HOOGOGOGO/-/(list of files, cad)

Other CAD files:
电子指南针/Objects/main.obj
电子指南针/Objects/led.obj
电子指南针/Objects/sys.obj
电子指南针/Objects/iic.obj
