HOOGOGOGO/-/电子指南针/sys/led.c

//本程序只供学习使用，未经作者许可，不得用于其它任何用途
//测试硬件：单片机STC89C52,晶振11.0592M  单片机工作电压3.8V
//QDtech-TFT液晶驱动 for C51
//协会网站:https://hoogogogo.github.io/YanZhiBo/
//协会提供技术支持，任何技术问题欢迎随时交流学习
//邮箱:1711446177@qq.com
//技术交流QQ群:111446177
//创建日期:2024/9/7
//版本：V1.0
//版权所有，盗版必究。
//Copyright(C) 燕之波协会 2024-2034
#include "sys.h"
#include "led.h"

//LCD的画笔颜色和背景色	   
extern u16  POINT_COLOR=WHITE;	//画笔颜色
extern u16  BACK_COLOR=BLACK;  //背景色 

u8 size=24;


//LCD重要参数集
typedef struct  
{										    
	u8 width;			//LCD 宽度
	u8 height;			//LCD 高度
	u16 id;				//LCD ID
	u8  dir;			//横屏还是竖屏控制：0，竖屏；1，横屏。	
	u16	 wramcmd;		//开始写gram指令
	u16  setxcmd;		//设置x坐标指令
	u16  setycmd;		//设置y坐标指令
	u8   xoffset;    
  u8	 yoffset;	
}_lcd_dev; 	


//管理LCD重要参数
//默认为竖屏
_lcd_dev lcddev;

//24*24 ASICII字符集点阵
unsigned char code ascii_2412[27][36]={  
{0x00,0x00,0x00,0x00,0x00,0x00,0x00,0x00,0x00,0x00,0x00,0x00,0x00,0x00,0x00,0x00,0x00,0x00,0x00,0x00,0x00,0x00,0x00,0x00,0x00,0x00,0x00,0x00,0x00,0x00,0x00,0x00,0x00,0x00,0x00,0x00},/*" ",0*/
{0x00,0x00,0x00,0x00,0x00,0x00,0x00,0x00,0x00,0x00,0x00,0x00,0x00,0x00,0x00,0x0F,0x80,0x38,0x0F,0xFE,0x38,0x0F,0x80,0x38,0x00,0x00,0x00,0x00,0x00,0x00,0x00,0x00,0x00,0x00,0x00,0x00},/*"!",1*/
{0x00,0x00,0x00,0x00,0x00,0x00,0x01,0x00,0x00,0x06,0x00,0x00,0x0C,0x00,0x00,0x38,0x00,0x00,0x31,0x00,0x00,0x06,0x00,0x00,0x0C,0x00,0x00,0x38,0x00,0x00,0x30,0x00,0x00,0x00,0x00,0x00},/*""",2*/
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
 * @retvalue   :None
******************************************************************************/
void spi_write_byte(u8 d)
{
	u8 val=0x80;
	while(val)
	{
		if(d&val)
		{
			LCD_SDI = 1;
		}
		else
		{
			LCD_SDI = 0;
		}
		LCD_CLK = 0;
		LCD_CLK = 1;
		val>>=1;
	}
}

/*****************************************************************************
 * @name       :void LCD_WR_REG(u8 data)
 * @date       :2018-08-09 
 * @function   :Write an 8-bit command to the LCD screen
 * @parameters :data:Command value to be written
 * @retvalue   :None
******************************************************************************/
void LCD_WR_REG(u8 Reg)	 
{	
	LCD_RS=0;
	LCD_CS=0;
	spi_write_byte(Reg);
	LCD_CS=1;
} 

/*****************************************************************************
 * @name       :void LCD_WR_DATA(u8 data)
 * @date       :2018-08-09 
 * @function   :Write an 8-bit data to the LCD screen
 * @parameters :data:data value to be written
 * @retvalue   :None
******************************************************************************/
 void LCD_WR_DATA(u8 Data)
{
	LCD_RS=1;
	LCD_CS=0;
	spi_write_byte(Data);
	LCD_CS=1;
}

/*****************************************************************************
 * @name       :void LCD_WR_DATA_16Bit(u16 Data)
 * @date       :2018-08-09 
 * @function   :Write an 16-bit command to the LCD screen
 * @parameters :Data:Data to be written
 * @retvalue   :None
******************************************************************************/	 
void LCD_WR_DATA_16Bit(u16 Data)
{
	LCD_CS=0;
	LCD_RS=1;
	spi_write_byte(Data>>8);
	spi_write_byte(Data);
	LCD_CS=1;
}

/*****************************************************************************
 * @name       :void LCD_WriteReg(u8 LCD_Reg, u16 LCD_RegValue)
 * @date       :2018-08-09 
 * @function   :Write data into registers
 * @parameters :LCD_Reg:Register address
                LCD_RegValue:Data to be written
 * @retvalue   :None
******************************************************************************/
void LCD_WriteReg(u8 LCD_Reg, u8 LCD_RegValue)
{
  LCD_WR_REG(LCD_Reg);
	LCD_WR_DATA(LCD_RegValue);
}

/*****************************************************************************
 * @name       :void LCD_WriteRAM_Prepare(void)
 * @date       :2018-08-09 
 * @function   :Write GRAM
 * @parameters :None
 * @retvalue   :None
******************************************************************************/	
void LCD_WriteRAM_Prepare(void)
{
 	LCD_WR_REG(lcddev.wramcmd);	  
}

/*****************************************************************************
 * @name       :void LCD_Clear(u16 Color)
 * @date       :2018-08-09 
 * @function   :Full screen filled LCD screen
 * @parameters :color:Filled color
 * @retvalue   :None
******************************************************************************/	
void LCD_Clear(u16 Color)
{
	u16 i,j;
	LCD_SetWindows(0,0,lcddev.width-1,lcddev.height-1);	
	LCD_CS=0;
	LCD_RS=1;
    for(i=0;i<lcddev.width;i++)
	 {
	  for (j=0;j<lcddev.height;j++)
	   	{
        spi_write_byte(Color>>8);
				spi_write_byte(Color);
	    }

	  }
	LCD_CS=1;
}

/*****************************************************************************
 * @name       :void LCD_DrawPoint(u16 x,u16 y)
 * @date       :2018-08-09 
 * @function   :Write a pixel data at a specified location
 * @parameters :x:the x coordinate of the pixel
                y:the y coordinate of the pixel
 * @retvalue   :None
******************************************************************************/	
void LCD_DrawPoint(u16 x,u16 y,u16 color)
{
	LCD_SetWindows(x,y,x,y);//设置光标位置 
	LCD_WR_DATA_16Bit(color); 	    
} 	 

/*****************************************************************************
 * @name       :void LCD_Reset(void)
 * @date       :2018-08-09 
 * @function   :Reset LCD screen
 * @parameters :None
 * @retvalue   :None
******************************************************************************/	
void LCD_Reset(void)
{	
	LCD_RESET=0;
	delay_ms(20);
	LCD_RESET=1;
	delay_ms(20);
}

/*****************************************************************************
 * @name       :void LCD_Init(void)
 * @date       :2018-08-09 
 * @function   :Initialization LCD screen
 * @parameters :None
 * @retvalue   :None
******************************************************************************/	 	 
void LCD_Init(void)
{
	LCD_Reset(); //初始化之前复位
//************* ST7789 IPS初始化**********//	
	LCD_WR_REG(0x36); 
	LCD_WR_DATA(0x00);

	LCD_WR_REG(0x3A); 
	LCD_WR_DATA(0x05);

	LCD_WR_REG(0xB2);
	LCD_WR_DATA(0x0C);
	LCD_WR_DATA(0x0C);
	LCD_WR_DATA(0x00);
	LCD_WR_DATA(0x33);
	LCD_WR_DATA(0x33);

	LCD_WR_REG(0xB7); 
	LCD_WR_DATA(0x35);  

	LCD_WR_REG(0xBB);
	LCD_WR_DATA(0x17);

	LCD_WR_REG(0xC0);
	LCD_WR_DATA(0x2C);

	LCD_WR_REG(0xC2);
	LCD_WR_DATA(0x01);

	LCD_WR_REG(0xC3);
	LCD_WR_DATA(0x12);   

	LCD_WR_REG(0xC4);
	LCD_WR_DATA(0x20);  

	LCD_WR_REG(0xC6); 
	LCD_WR_DATA(0x0F);    

	LCD_WR_REG(0xD0); 
	LCD_WR_DATA(0xA4);
	LCD_WR_DATA(0xA1);

	LCD_WR_REG(0xE0);
	LCD_WR_DATA(0xD0);
	LCD_WR_DATA(0x04);
	LCD_WR_DATA(0x0D);
	LCD_WR_DATA(0x11);
	LCD_WR_DATA(0x13);
	LCD_WR_DATA(0x2B);
	LCD_WR_DATA(0x3F);
	LCD_WR_DATA(0x54);
	LCD_WR_DATA(0x4C);
	LCD_WR_DATA(0x18);
	LCD_WR_DATA(0x0D);
	LCD_WR_DATA(0x0B);
	LCD_WR_DATA(0x1F);
	LCD_WR_DATA(0x23);

	LCD_WR_REG(0xE1);
	LCD_WR_DATA(0xD0);
	LCD_WR_DATA(0x04);
	LCD_WR_DATA(0x0C);
	LCD_WR_DATA(0x11);
	LCD_WR_DATA(0x13);
	LCD_WR_DATA(0x2C);
	LCD_WR_DATA(0x3F);
	LCD_WR_DATA(0x44);
	LCD_WR_DATA(0x51);
	LCD_WR_DATA(0x2F);
	LCD_WR_DATA(0x1F);
	LCD_WR_DATA(0x1F);
	LCD_WR_DATA(0x20);
	LCD_WR_DATA(0x23);

	LCD_WR_REG(0x21); 

	LCD_WR_REG(0x11); 
	//Delay (120); 

	LCD_WR_REG(0x29); 		

	//设置LCD属性参数
	LCD_direction(USE_HORIZONTAL);//设置LCD显示方向 
	LCD_BL=1;//点亮背光	 
}
 
/*****************************************************************************
 * @name       :void LCD_SetWindows(u16 xStar, u16 yStar,u16 xEnd,u16 yEnd)
 * @date       :2018-08-09 
 * @function   :Setting LCD display window
 * @parameters :xStar:the bebinning x coordinate of the LCD display window
								yStar:the bebinning y coordinate of the LCD display window
								xEnd:the endning x coordinate of the LCD display window
								yEnd:the endning y coordinate of the LCD display window
 * @retvalue   :None
******************************************************************************/ 
void LCD_SetWindows(u16 xStar, u16 yStar,u16 xEnd,u16 yEnd)
{	
	LCD_WR_REG(lcddev.setxcmd);	
	LCD_WR_DATA((xStar+lcddev.xoffset)>>8);
	LCD_WR_DATA(xStar+lcddev.xoffset);		
	LCD_WR_DATA((xEnd+lcddev.xoffset)>>8);
	LCD_WR_DATA(xEnd+lcddev.xoffset);

	LCD_WR_REG(lcddev.setycmd);	
	LCD_WR_DATA((yStar+lcddev.yoffset)>>8);
	LCD_WR_DATA(yStar+lcddev.yoffset);		
	LCD_WR_DATA((yEnd+lcddev.yoffset)>>8);
	LCD_WR_DATA(yEnd+lcddev.yoffset);

	LCD_WriteRAM_Prepare();	//开始写入GRAM				
}   

/*****************************************************************************
 * @name       :void LCD_SetCursor(u16 Xpos, u16 Ypos)
 * @date       :2018-08-09 
 * @function   :Set coordinate value
 * @parameters :Xpos:the  x coordinate of the pixel
								Ypos:the  y coordinate of the pixel
 * @retvalue   :None
******************************************************************************/ 
void LCD_SetCursor(u16 Xpos, u16 Ypos)
{	  	    			
	LCD_SetWindows(Xpos,Ypos,Xpos,Ypos);	
} 

/*****************************************************************************
 * @name       :void LCD_direction(u8 direction)
 * @date       :2018-08-09 
 * @function   :Setting the display direction of LCD screen
 * @parameters :direction:0-0 degree
                          1-90 degree
													2-180 degree
													3-270 degree
 * @retvalue   :None
******************************************************************************/ 
void LCD_direction(u8 direction)
{ 
	lcddev.setxcmd=0x2A;
			lcddev.setycmd=0x2B;
			lcddev.wramcmd=0x2C;
			lcddev.dir = direction%4;
	switch(lcddev.dir){		  
		case 0:						 	 		
			lcddev.width=LCD_W;
			lcddev.height=LCD_H;	
			lcddev.xoffset=0;
			lcddev.yoffset=0;
			LCD_WriteReg(0x36,0);//BGR==1,MY==0,MX==0,MV==0
		break;
		case 1:
			lcddev.width=LCD_H;
			lcddev.height=LCD_W;
			lcddev.xoffset=0;
			lcddev.yoffset=0;
			LCD_WriteReg(0x36,(1<<6)|(1<<5));//BGR==1,MY==1,MX==0,MV==1
		break;
		case 2:						 	 		
			lcddev.width=LCD_W;
			lcddev.height=LCD_H;
      lcddev.xoffset=0;
			lcddev.yoffset=122;			
			LCD_WriteReg(0x36,(1<<6)|(1<<7));//BGR==1,MY==0,MX==0,MV==0
		break;
		case 3:
			lcddev.width=LCD_H;
			lcddev.height=LCD_W;
			lcddev.xoffset=122;
			lcddev.yoffset=0;
			LCD_WriteReg(0x36,(1<<7)|(1<<5));//BGR==1,MY==1,MX==0,MV==1
		break;	
		default:break;
	}		
}	 



/*****************************************         TFT屏幕显示函数        **********************************************************/
//在指定位置显示一个字符
//x,y:起始坐标
//num:要显示的字符:" "--->"~"
//size:字体大小 12/16/24
//mode:叠加方式(1)还是非叠加方式(0)
void LCD_ShowChar(u8 x,u8 y,u8 num,u8 mode)
{  							  
  u8 temp,t1,t;
	u8 y0=y;	
 	num=num-' ';//得到偏移后的值（ASCII字库是从空格开始取模，所以-' '就是对应字符的字库）
	for(t=0;t<(size/8+((size%8)?1:0))*(size/2);t++) //(size/8+((size%8)?1:0))*(size/2)://得到字体一个字符对应点阵集所占的字节数	
	{   
		if(size==24)temp=ascii_2412[num][t]; 	 	//调用2412字体
		else return;								//没有的字库
		for(t1=0;t1<8;t1++)
		{			    
			if(temp&0x80)LCD_DrawPoint(x,y,POINT_COLOR);
			else if(mode==0)LCD_DrawPoint(x,y);

			temp<<=1;
			y++;
			if(y>=lcddev.height)return;		//超区域了
			if((y-y0)==size)
			{
				y=y0;
				x++;
				if(x>=lcddev.width)return;	//超区域了
				break;
			}
		}  	 
	}  	    	   	 	  
}   

//显示字符串
//x,y:起点坐标
//width,height:区域大小  
//size:字体大小
//*p:字符串起始地址		  
void LCD_ShowString(u8 x,u8 y,u16 width,u16 height,u8 *p)
{         
	u8 x0=x;
	width+=x;
	height+=y;
    while((*p<='~')&&(*p>=' '))//判断是不是非法字符!
    {    
        if(x>=width){x=x0;y+=size;}
        if(y>=height)break;//退出
        LCD_ShowChar(x,y,*p,1);
        x+=size/2;
        p++;
    }  
}

//在指定区域内填充单个颜色
//(sx,sy),(ex,ey):填充矩形对角坐标,区域大小为:(ex-sx+1)*(ey-sy+1)   
//color:要填充的颜色
void LCD_Fill(u8 sx,u8 sy,u8 ex,u8 ey,u16 color)
{  	
	u8 i,j;				
	LCD_SetWindows(sx,sy,ex,ey);//设置显示窗口
	for(i=0;i<(ey-sy+1);i++)  //得到填充的高度
	{
		for(j=0;j<(ex-sx+1);j++) //得到填充的宽度
		LCD_WR_DATA_16Bit(color);	//写入数据 	 
	}
	LCD_SetWindows(0,0,lcddev.width-1,lcddev.height-1);//恢复窗口设置为全屏
}

//在指定位置画一个指定大小的圆
//(x,y):中心点
//r    :半径
void Draw_Circle(u8 x0,u8 y0,u8 r,u16 color)
{
	u8 a=0,b=r;
	int di;	  
	di=3-(r<<1);             //判断下个点位置的标志
	while(a<=b)
	{
		LCD_DrawPoint(x0+a,y0-b,color);             //5
 		LCD_DrawPoint(x0+b,y0-a,color);             //0           
		LCD_DrawPoint(x0+b,y0+a,color);             //4               
		LCD_DrawPoint(x0+a,y0+b,color);             //6 
		LCD_DrawPoint(x0-a,y0+b,color);             //1       
 		LCD_DrawPoint(x0-b,y0+a,color);             
		LCD_DrawPoint(x0-a,y0-b,color);             //2             
  	LCD_DrawPoint(x0-b,y0-a,color);             //7     	         
		a++;
		//使用Bresenham算法画圆     
		if(di<0)di +=4*a+6;	  
		else
		{
			di+=10+4*(a-b);   
			b--;
		} 						    
	}
} 

//m^n函数
//返回值:m^n次方.
u16 LCD_Pow(u8 m,u8 n)
{
	u16 result=1;	 
	while(n--)result*=m;    
	return result;
}	
//显示数字,高位为0,则不显示
//x,y :起点坐标	 
//len :数字的位数
//size:字体大小
//color:颜色 
//num:数值(0~4294967295);	 
//显示数字,高位为0,则不显示
//x,y :起点坐标	 
//len :数字的位数
//size:字体大小
//color:颜色 
//num:数值(0~4294967295);	 
void LCD_ShowNum(u8 x,u8 y,u16 num,u8 len)
{         	
	u8 t,temp;
	u8 enshow=0;						   
	for(t=0;t<len;t++)
	{
		temp=(num/LCD_Pow(10,len-t-1))%10;
		if(enshow==0&&t<(len-1))
		{
			if(temp==0)
			{
				LCD_ShowChar(x+(size/2)*t,y,' ',1);
				continue;
			}else enshow=1; 
		 	 
		}
	 	LCD_ShowChar(x+(size/2)*t,y,temp+'0',1); 
	}
}  


///*******************************************************************************
//* 函数名 : LCD_DrawLine
//* 函数功能 : 画一条直线
//* 输入参数 : x1,y1:起点坐标，x2,y2:终点坐标
//* 输出: 无
//*******************************************************************************/
void LCD_DrawLine(u8 x1, u8 y1, u8 x2, u8 y2,u16 color)
{
	u16 t; 
	int xerr=0,yerr=0,delta_x,delta_y,distance; 
	int incx,incy,uRow,uCol; 
	delta_x=x2-x1; //计算坐标增量 
	delta_y=y2-y1; 
	uRow=x1; 
	uCol=y1; 
	if(delta_x>0)incx=1; //设置单步方向 
	else if(delta_x==0)incx=0;//垂直线 
	else {incx=-1;delta_x=-delta_x;} 
	if(delta_y>0)incy=1; 
	else if(delta_y==0)incy=0;//水平线 
	else{incy=-1;delta_y=-delta_y;} 
	if( delta_x>delta_y)distance=delta_x; //选取基本增量坐标轴 
	else distance=delta_y; 
	for(t=0;t<=distance+1;t++ )//画线输出 
	{  
		LCD_DrawPoint(uRow,uCol,color);//画点 
		xerr+=delta_x ; 
		yerr+=delta_y ; 
		if(xerr>distance) 
		{ 
			xerr-=distance; 
			uRow+=incx; 
		} 
		if(yerr>distance) 
		{ 
			yerr-=distance; 
			uCol+=incy; 
		} 
	}  
} 
/****************************************************************************
*函数名：LCD_ShowFontHZ
*输  入：x：汉字显示的X坐标
*      * y：汉字显示的Y坐标
*      * cn：要显示的汉字
*      * wordColor：文字的颜色
*      * backColor：背景颜色
*输  出：
*功  能：写二号楷体汉字
****************************************************************************/
void LCD_ShowFontHZ(u8 x, u8 y, u8 *cn)	 
{  
	u8 i, j, wordNum;
	u16 color;
	while (*cn != '\0')
	{
		LCD_SetWindows(x, y, x+23, y+23);
		for (wordNum=0; wordNum<5; wordNum++)
		{	//wordNum扫描字库的字数
			if ((CnChar24x24[wordNum].Index[0]==*cn)
			     &&(CnChar24x24[wordNum].Index[1]==*(cn+1)))
			{
				for(i=0; i<72; i++) 
				{	//MSK的位数
					color=CnChar24x24[wordNum].Msk[i];
					for(j=0;j<8;j++) 
					{
						if((color&0x80)==0x80)
						{
							LCD_WR_DATA_16Bit(POINT_COLOR); 						
						} 						
						else
						{
							LCD_WR_DATA_16Bit(BACK_COLOR); 
						} 
						color<<=1;
					}//for(j=0;j<8;j++)结束
				}    
			}
		} //for (wordNum=0; wordNum<20; wordNum++)结束 	
		cn += 2;
		x += 24;
	}
}
