HOOGOGOGO/-/(notices)

Notices in the files:
电子指南针/main.c:
Copyright(C) ÑàÖ®²¨Ð­»á 2024-2034
